Crem2y/rp2350a_main_board/documentation/pcb.png

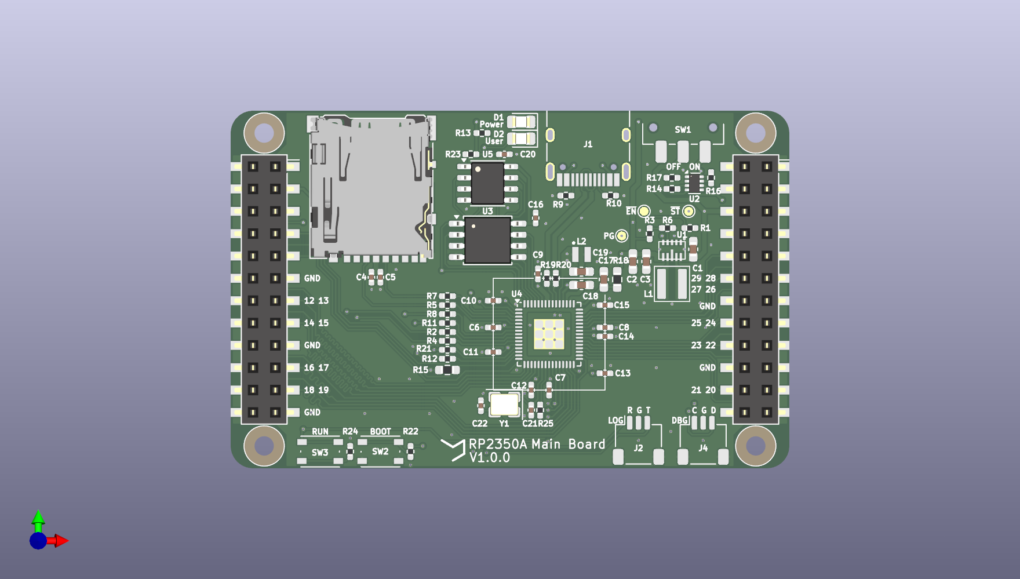
documentation/pcb.png
