Crem2y/rp2350a_main_board/documentation/schematics.pdf

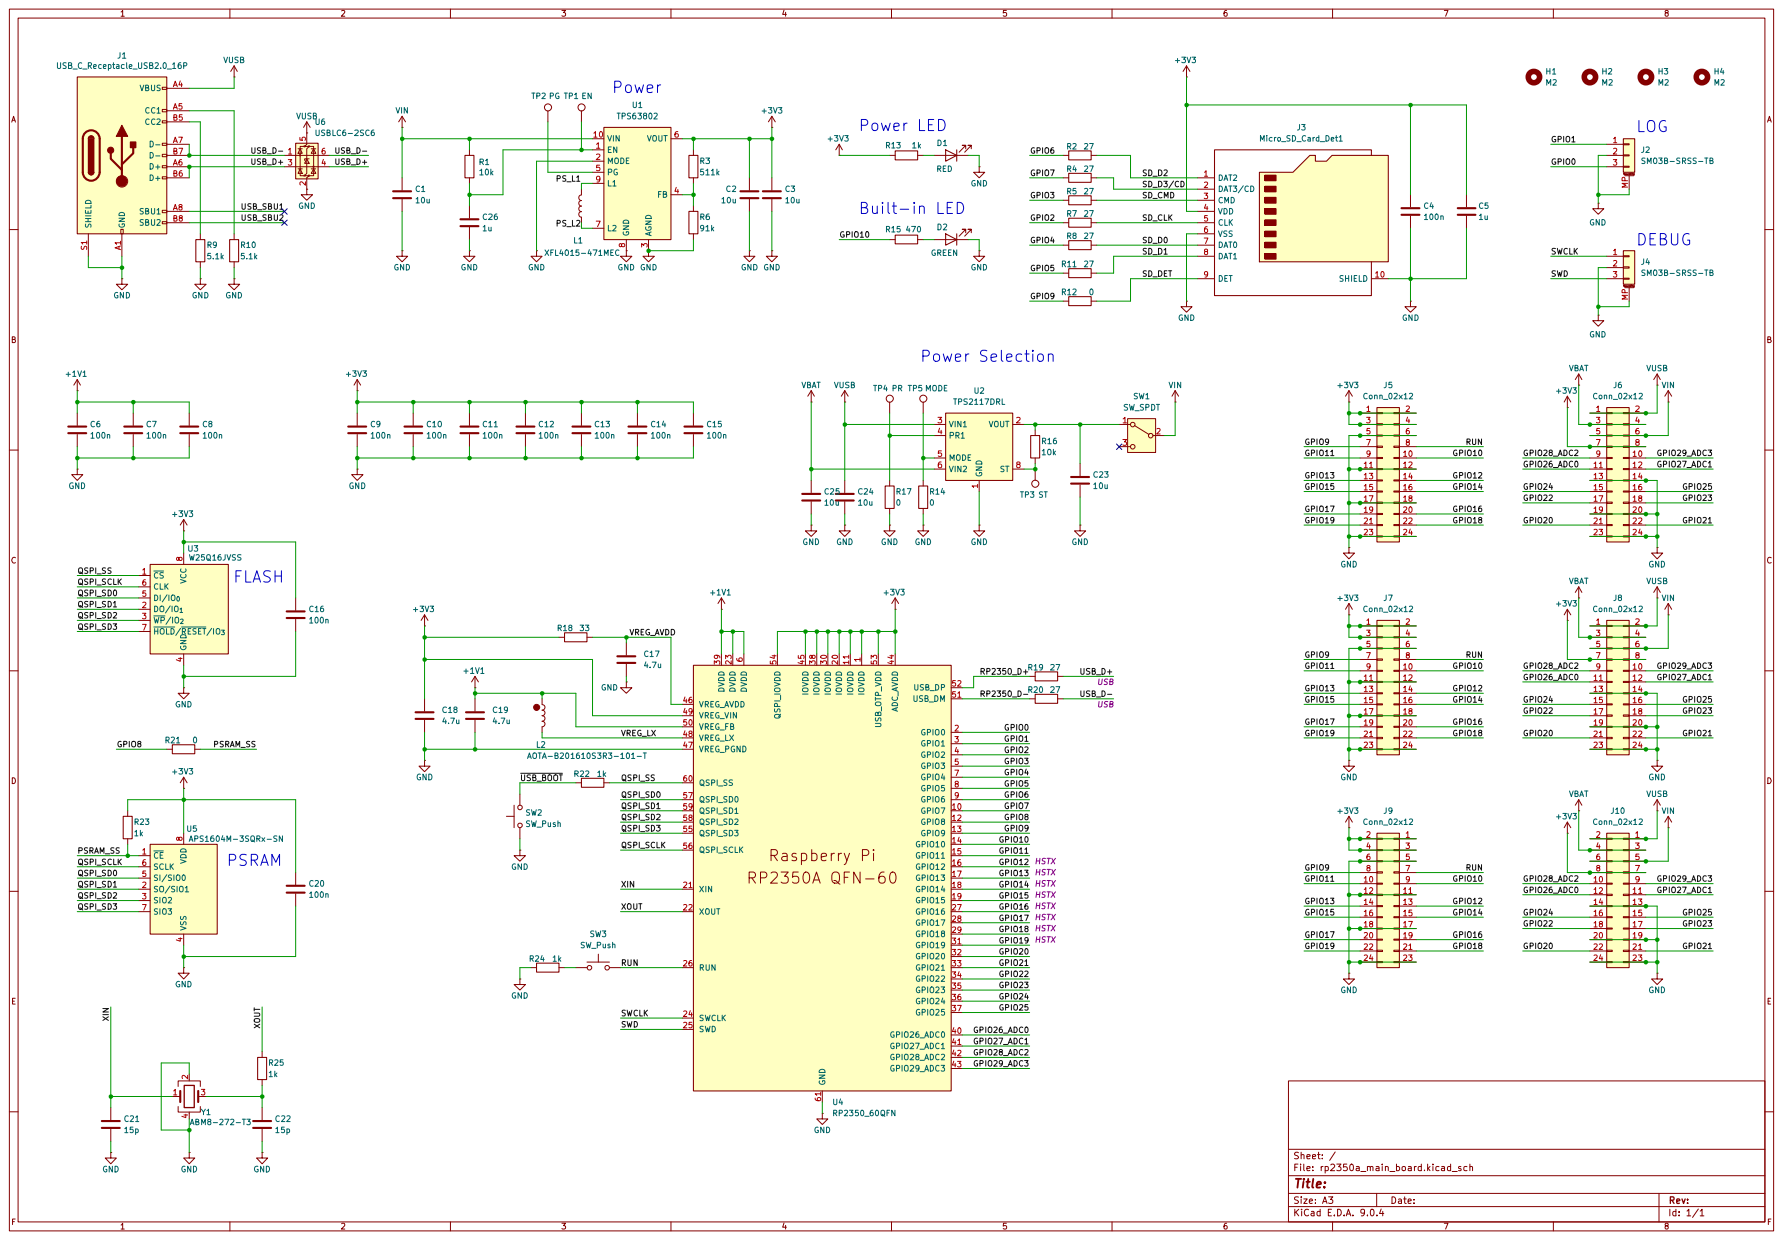
[picture p7: page 1]
