Crem2y/rp2350a_main_board/documentation/old_1.0.0/schematics.pdf

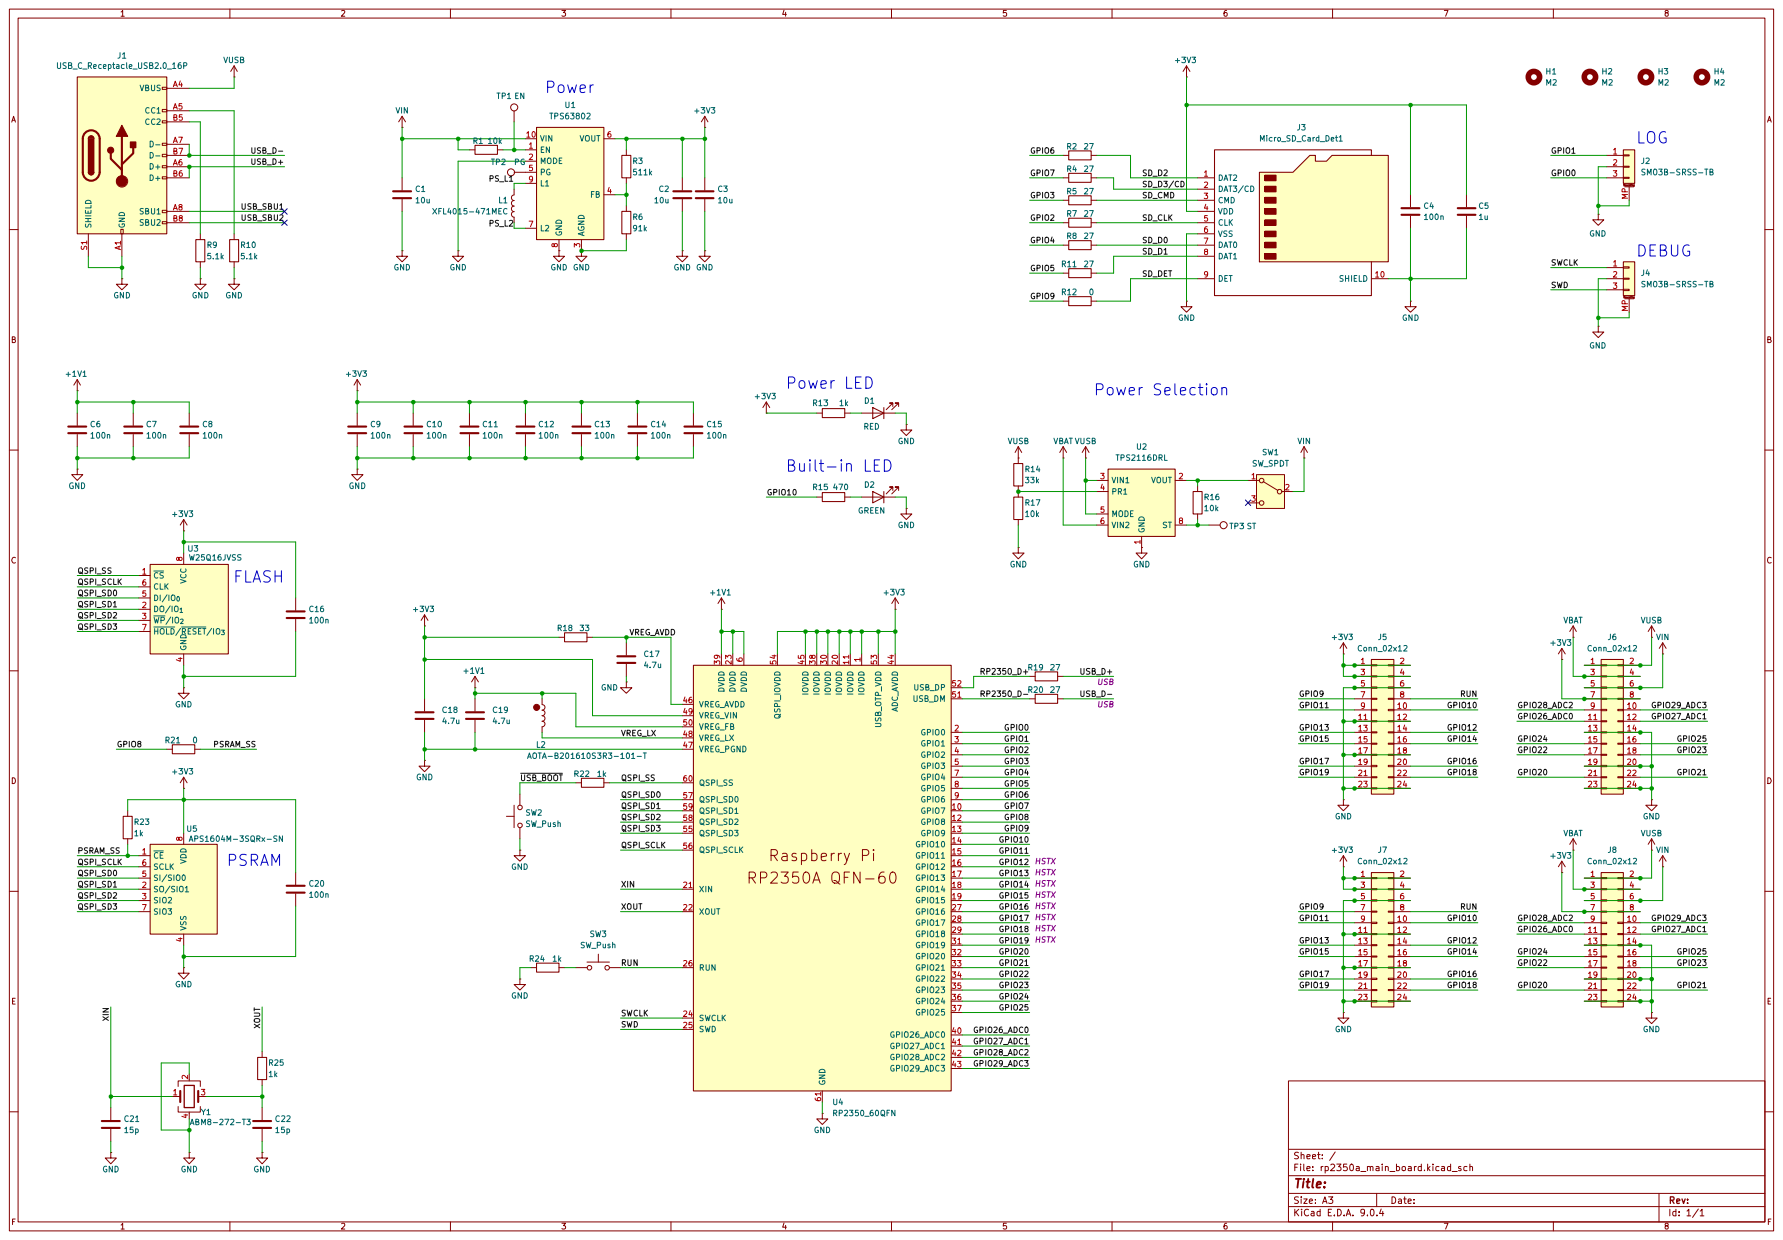
[picture p8: page 1]
