Crem2y/rp2350a_main_board/rp2350a_main_board.kicad_pcb

## KiCad design rp2350a_main_board.kicad_pcb (2026-08-28)

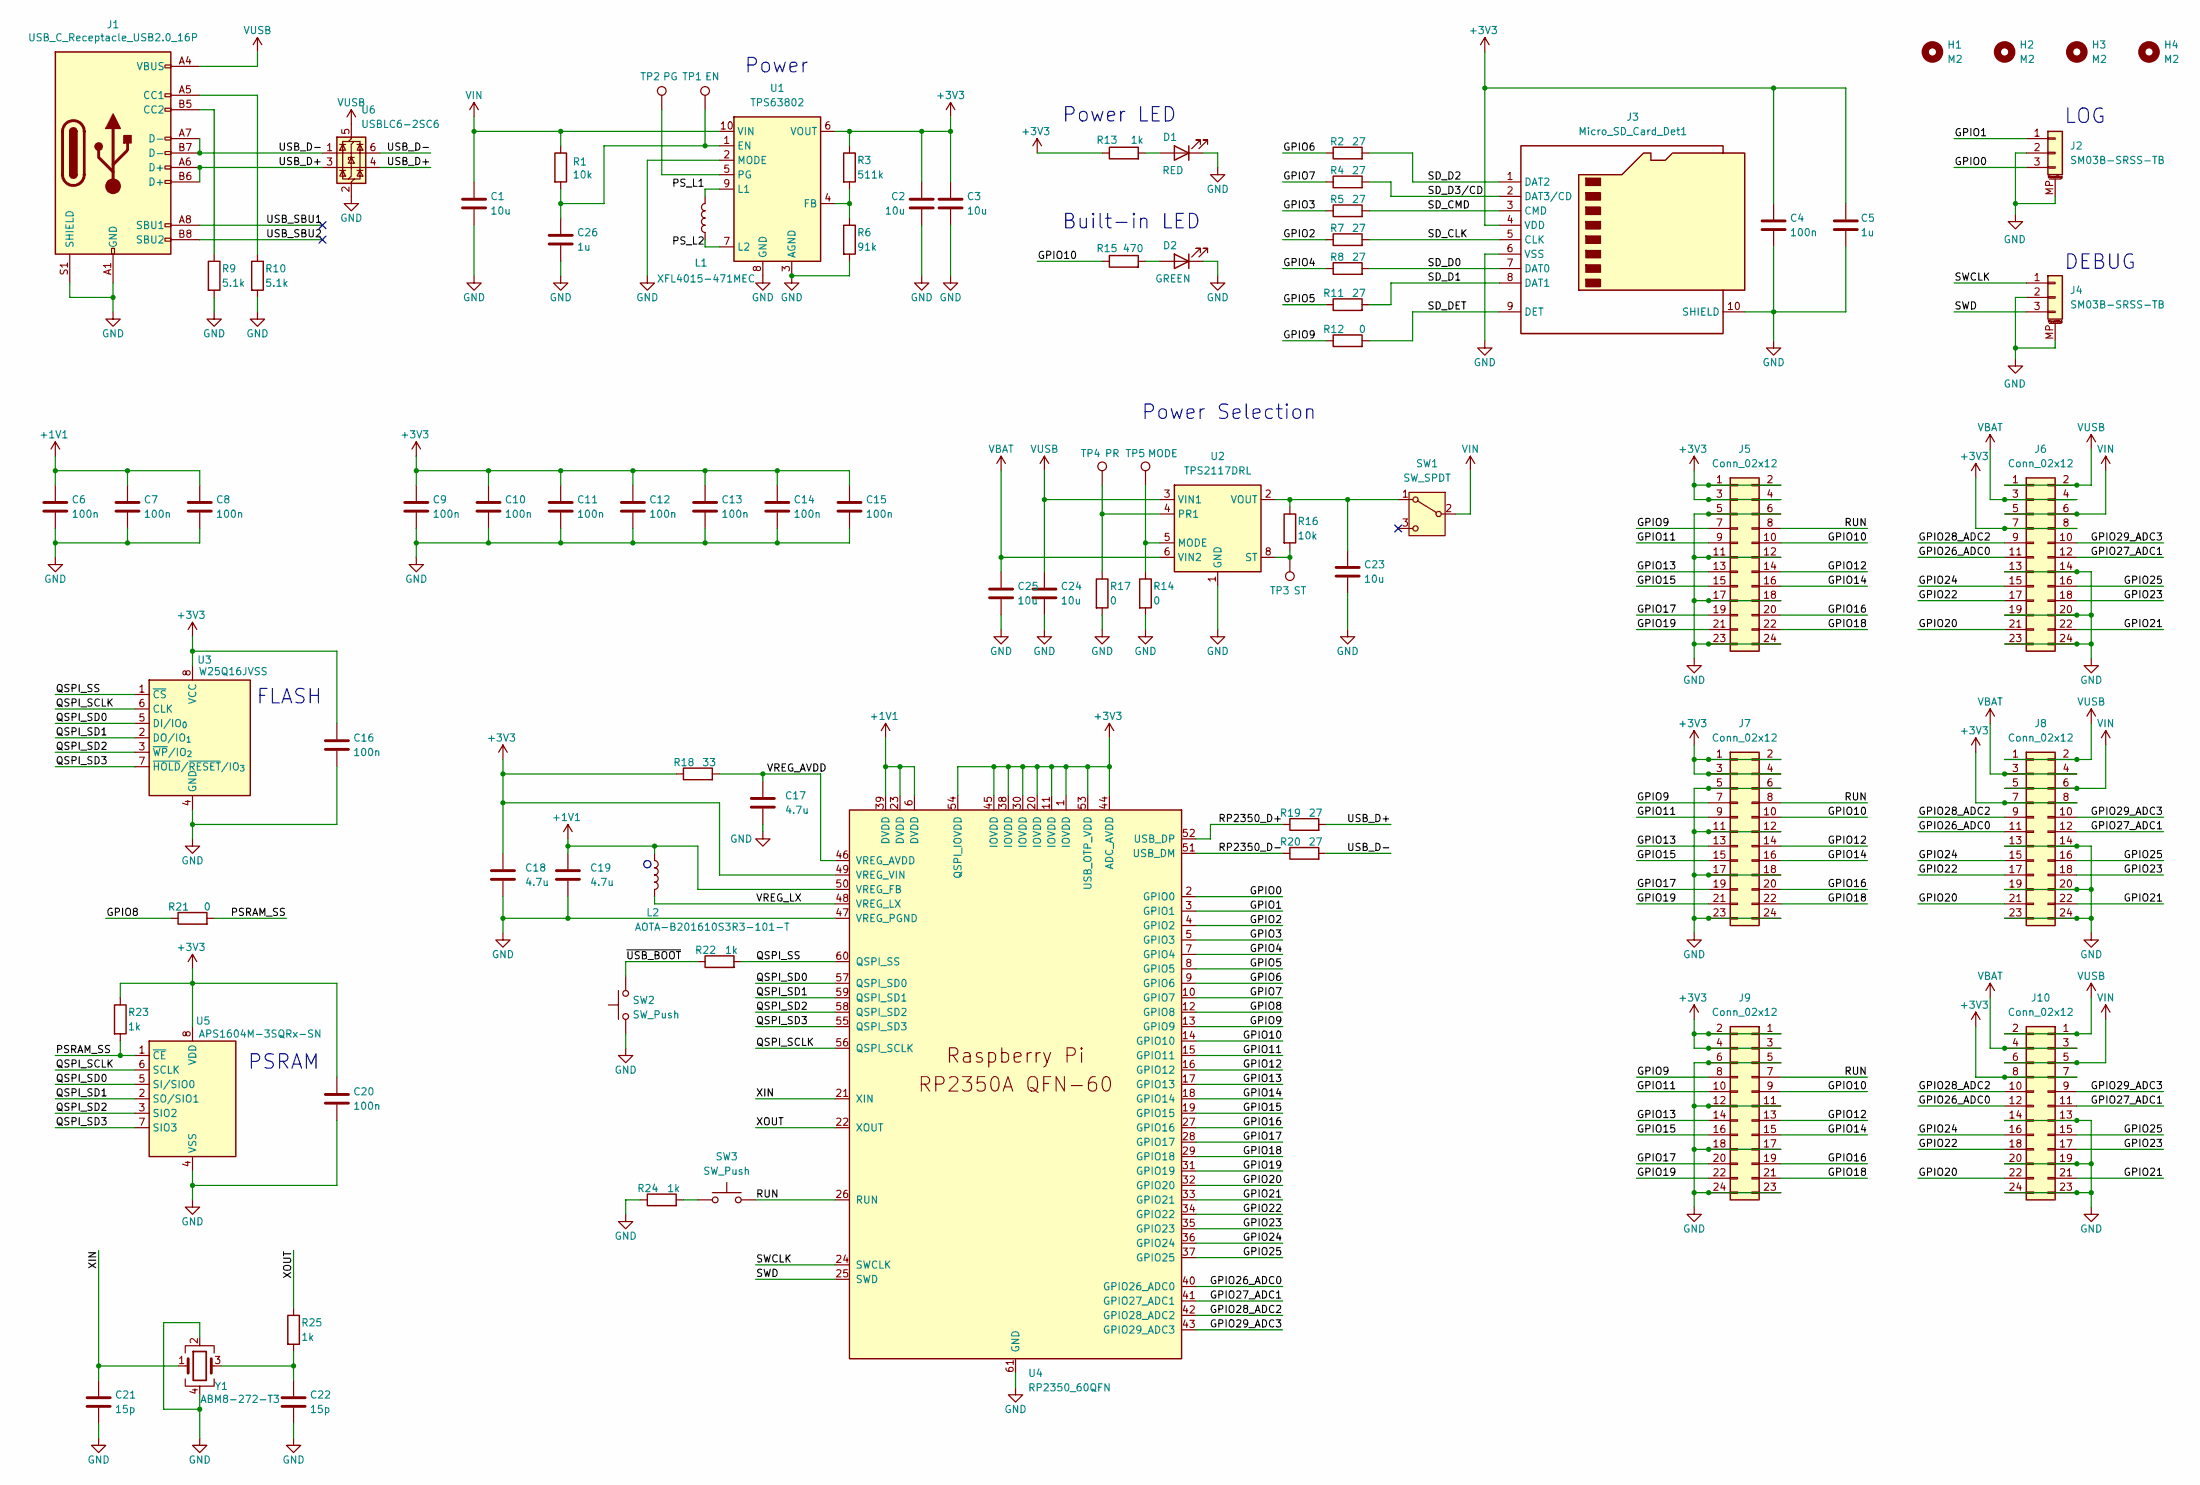
[picture p9: schematic rp2350a_main_board.kicad_sch]

Parts:
C1, C2, C3, C23, C24, C25: 10u; C_0603_1608Metric_Pad1.08x0.95mm_HandSolder
C4, C6, C7, C8, C9, C10, C11, C12, C13, C14, C15, C16, C20: 100n; C_0402_1005Metric_Pad0.74x0.62mm_HandSolder
C5, C26: 1u; C_0402_1005Metric_Pad0.74x0.62mm_HandSolder
C17, C18, C19: 4.7u; C_0603_1608Metric_Pad1.08x0.95mm_HandSolder
C21, C22: 15p; C_0402_1005Metric_Pad0.74x0.62mm_HandSolder
D1: RED; LED_0805_2012Metric_Pad1.15x1.40mm_HandSolder
D2: GREEN; LED_0805_2012Metric_Pad1.15x1.40mm_HandSolder
H1, H2, H3, H4: M2; MountingHole_2.2mm_M2
J1: USB_C_Receptacle_USB2.0_16P; USB_C_Receptacle_HRO_TYPE-C-31-M-12
J2, J4: SM03B-SRSS-TB; JST_SH_SM03B-SRSS-TB_1x03-1MP_P1.00mm_Horizontal
J3: Micro_SD_Card_Det1; microSD_HC_Hirose_DM3AT-SF-PEJM5
J5, J6: Conn_02x12; PinSocket_2x12_P2.54mm_Vertical
J7, J8, J9, J10: Conn_02x12; PinSocket_2x12_P2.54mm_Vertical_SMD
L1: XFL4015-471MEC; Inductor_SMD_L_4.0x4.0_H1.5
L2: AOTA-B201610S3R3-101-T; L_pol_2016
R1, R16: 10k; R_0402_1005Metric_Pad0.72x0.64mm_HandSolder
R2, R4, R5, R7, R8, R11, R19, R20: 27; R_0402_1005Metric_Pad0.72x0.64mm_HandSolder
R3: 511k; R_0402_1005Metric_Pad0.72x0.64mm_HandSolder
R6: 91k; R_0402_1005Metric_Pad0.72x0.64mm_HandSolder
R9, R10: 5.1k; R_0402_1005Metric_Pad0.72x0.64mm_HandSolder
R12, R14, R17, R21: 0; R_0402_1005Metric_Pad0.72x0.64mm_HandSolder
R13, R22, R23, R24, R25: 1k; R_0402_1005Metric_Pad0.72x0.64mm_HandSolder
R15: 470; R_0402_1005Metric_Pad0.72x0.64mm_HandSolder
R18: 33; R_0603_1608Metric_Pad0.98x0.95mm_HandSolder
SW1: SW_SPDT; SW_SPDT_CK_JS102011SAQN
SW2, SW3: SW_Push; SW_Push_1P1T_NO_Vertical_Wuerth_434133025816
TP1: EN; TestPoint_Pad_D1.0mm
TP2: PG; TestPoint_Pad_D1.0mm
TP3: ST; TestPoint_Pad_D1.0mm
TP4: PR; TestPoint_Pad_D1.0mm
TP5: MODE; TestPoint_Pad_D1.0mm
U1: TPS63802
U2: TPS2117DRL; SOT-583-8
U3: W25Q16JVSS; SOIC-8_5.3x5.3mm_P1.27mm
U4: RP2350_60QFN; QFN-60-1EP_7x7mm_P0.4mm_EP3.4x3.4mm; LCSC PN C42411118
U5: APS1604M-3SQRx-SN; SOIC-8_3.9x4.9mm_P1.27mm
U6: USBLC6-2SC6; SOT-23-6
Y1: ABM8-272-T3; Crystal_SMD_3225-4Pin_3.2x2.5mm; LCSC PN C20625731

Connections:
+1V1: C6.1, C7.1, C8.1, C19.1, L2.1, U4.6 (DVDD), U4.23 (DVDD), U4.39 (DVDD), U4.50 (VREG_FB)
+3V3: C2.1, C3.1, C4.1, C5.1, C9.1, C10.1, C11.1, C12.1, C13.1, C14.1, C15.1, C16.1, C18.1, C20.1, J3.4 (VDD), J5.1, J5.2, J5.3, J5.4, J6.7, J6.8, J7.1, J7.2, J7.3, J7.4, J8.7, J8.8, J9.1, J9.2, J9.3, J9.4, J10.7, J10.8, R3.1, R13.1, R18.1, R23.1, U1.6 (VOUT), U3.8 (VCC), U4.1 (IOVDD), U4.11 (IOVDD), U4.20 (IOVDD), U4.30 (IOVDD), U4.38 (IOVDD), U4.44 (ADC_AVDD), U4.45 (IOVDD), U4.49 (VREG_VIN), U4.53 (USB_OTP_VDD), U4.54 (QSPI_IOVDD), U5.8 (VDD)
/GPIO0: J2.3, U4.2 (GPIO0)
/GPIO1: J2.1, U4.3 (GPIO1)
/GPIO2: R7.1, U4.4 (GPIO2)
/GPIO3: R5.1, U4.5 (GPIO3)
/GPIO4: R8.1, U4.7 (GPIO4)
/GPIO5: R11.1, U4.8 (GPIO5)
/GPIO6: R2.1, U4.9 (GPIO6)
/GPIO7: R4.1, U4.10 (GPIO7)
/GPIO8: R21.1, U4.12 (GPIO8)
/GPIO9: J5.7, J7.7, J9.8, R12.1, U4.13 (GPIO9)
/GPIO10: J5.10, J7.10, J9.9, R15.1, U4.14 (GPIO10)
/GPIO11: J5.9, J7.9, J9.10, U4.15 (GPIO11)
/GPIO12: J5.14, J7.14, J9.13, U4.16 (GPIO12)
/GPIO13: J5.13, J7.13, J9.14, U4.17 (GPIO13)
/GPIO14: J5.16, J7.16, J9.15, U4.18 (GPIO14)
/GPIO15: J5.15, J7.15, J9.16, U4.19 (GPIO15)
/GPIO16: J5.20, J7.20, J9.19, U4.27 (GPIO16)
/GPIO17: J5.19, J7.19, J9.20, U4.28 (GPIO17)
/GPIO18: J5.22, J7.22, J9.21, U4.29 (GPIO18)
/GPIO19: J5.21, J7.21, J9.22, U4.31 (GPIO19)
/GPIO20: J6.21, J8.21, J10.22, U4.32 (GPIO20)
/GPIO21: J6.22, J8.22, J10.21, U4.33 (GPIO21)
/GPIO22: J6.17, J8.17, J10.18, U4.34 (GPIO22)
/GPIO23: J6.18, J8.18, J10.17, U4.35 (GPIO23)
/GPIO24: J6.15, J8.15, J10.16, U4.36 (GPIO24)
/GPIO25: J6.16, J8.16, J10.15, U4.37 (GPIO25)
/GPIO26_ADC0: J6.11, J8.11, J10.12, U4.40 (GPIO26_ADC0)
/GPIO27_ADC1: J6.12, J8.12, J10.11, U4.41 (GPIO27_ADC1)
/GPIO28_ADC2: J6.9, J8.9, J10.10, U4.42 (GPIO28_ADC2)
/GPIO29_ADC3: J6.10, J8.10, J10.9, U4.43 (GPIO29_ADC3)
/PSRAM_SS: R21.2, R23.2, U5.1 (~CE)
/PS_L1: L1.1, U1.9 (L1)
/PS_L2: L1.2, U1.7 (L2)
/QSPI_SCLK: U3.6 (CLK), U4.56 (QSPI_SCLK), U5.6 (SCLK)
/QSPI_SD0: U3.5 (DI/IO_{0}), U4.57 (QSPI_SD0), U5.5 (SI/SIO0)
/QSPI_SD1: U3.2 (DO/IO_{1}), U4.59 (QSPI_SD1), U5.2 (SO/SIO1)
/QSPI_SD2: U3.3 (~WP/IO_{2}), U4.58 (QSPI_SD2), U5.3 (SIO2)
/QSPI_SD3: U3.7 (~HOLD/~RESET/IO_{3}), U4.55 (QSPI_SD3), U5.7 (SIO3)
/QSPI_SS: R22.2, U3.1 (~CS), U4.60 (QSPI_SS)
/RP2350_D+: R19.1, U4.52 (USB_DP)
/RP2350_D-: R20.1, U4.51 (USB_DM)
/RUN: J5.8, J7.8, J9.7, SW3.2, U4.26 (RUN)
/SD_CLK: J3.5 (CLK), R7.2
/SD_CMD: J3.3 (CMD), R5.2
/SD_D0: J3.7 (DAT0), R8.2
/SD_D1: J3.8 (DAT1), R11.2
/SD_D2: J3.1 (DAT2), R2.2
/SD_D3/CD: J3.2 (DAT3/CD), R4.2
/SD_DET: J3.9 (DET), R12.2
/SWCLK: J4.1, U4.24 (SWCLK)
/SWD: J4.3, U4.25 (SWD)
/USB_D+: J1.A6 (D+), J1.B6 (D+), R19.2, U6.3 (I/O2), U6.4 (I/O2)
/USB_D-: J1.A7 (D-), J1.B7 (D-), R20.2, U6.1 (I/O1), U6.6 (I/O1)
/USB_SBU1: J1.A8 (SBU1)
/USB_SBU2: J1.B8 (SBU2)
/VREG_AVDD: C17.1, R18.2, U4.46 (VREG_AVDD)
/VREG_LX: L2.2, U4.48 (VREG_LX)
/XIN: C21.1, U4.21 (XIN), Y1.1
/XOUT: R25.1, U4.22 (XOUT)
/~USB_BOOT: R22.1, SW2.2
GND: C1.2, C2.2, C3.2, C4.2, C5.2, C6.2, C7.2, C8.2, C9.2, C10.2, C11.2, C12.2, C13.2, C14.2, C15.2, C16.2, C17.2, C18.2, C19.2, C20.2, C21.2, C22.2, C23.2, C24.2, C25.2, C26.2, D1.1 (K), D2.1 (K), J1.A1 (GND), J1.A12 (GND), J1.B1 (GND), J1.B12 (GND), J1.S1 (SHIELD), J2.2, J2.MP (MountPin), J3.6 (VSS), J3.10 (SHIELD), J4.2, J4.MP (MountPin), J5.5, J5.6, J5.11, J5.12, J5.17, J5.18, J5.23, J5.24, J6.13, J6.14, J6.19, J6.20, J6.23, J6.24, J7.5, J7.6, J7.11, J7.12, J7.17, J7.18, J7.23, J7.24, J8.13, J8.14, J8.19, J8.20, J8.23, J8.24, J9.5, J9.6, J9.11, J9.12, J9.17, J9.18, J9.23, J9.24, J10.13, J10.14, J10.19, J10.20, J10.23, J10.24, R6.2, R9.2, R10.2, R14.2, R17.2, R24.1, SW2.1, U1.2 (MODE), U1.3 (AGND), U1.8 (GND), U2.1 (GND), U3.4 (GND), U4.47 (VREG_PGND), U4.61 (GND), U5.4 (VSS), U6.2 (GND), Y1.2, Y1.4
unnamed: C22.1, R25.2, Y1.3
unnamed: D1.2 (A), R13.2
unnamed: D2.2 (A), R15.2
unnamed: J1.A5 (CC1), R10.1
unnamed: J1.B5 (CC2), R9.1
unnamed: R24.2, SW3.1
unnamed: C23.1, R16.1, SW1.1 (A), U2.2 (VOUT), U2.7 (VOUT)
unnamed: C26.1, R1.2, TP1.1, U1.1 (EN)
unnamed: R3.2, R6.1, U1.4 (FB)
unnamed: TP2.1, U1.5 (PG)
unnamed: R14.1, TP5.1, U2.5 (MODE)
unnamed: R17.1, TP4.1, U2.4 (PR1)
unnamed: R16.2, TP3.1, U2.8 (ST)
VBAT: C25.1, J6.3, J6.4, J8.3, J8.4, J10.3, J10.4, U2.6 (VIN2)
VIN: C1.1, J6.5, J6.6, J8.5, J8.6, J10.5, J10.6, R1.1, SW1.2 (B), U1.10 (VIN)
VUSB: C24.1, J1.A4 (VBUS), J1.A9 (VBUS), J1.B4 (VBUS), J1.B9 (VBUS), J6.1, J6.2, J8.1, J8.2, J10.1, J10.2, U2.3 (VIN1), U6.5 (VBUS)

Notes on the sheet:
DEBUG
FLASH
Built-in LED
Power LED
PSRAM
Power
LOG
Power Selection

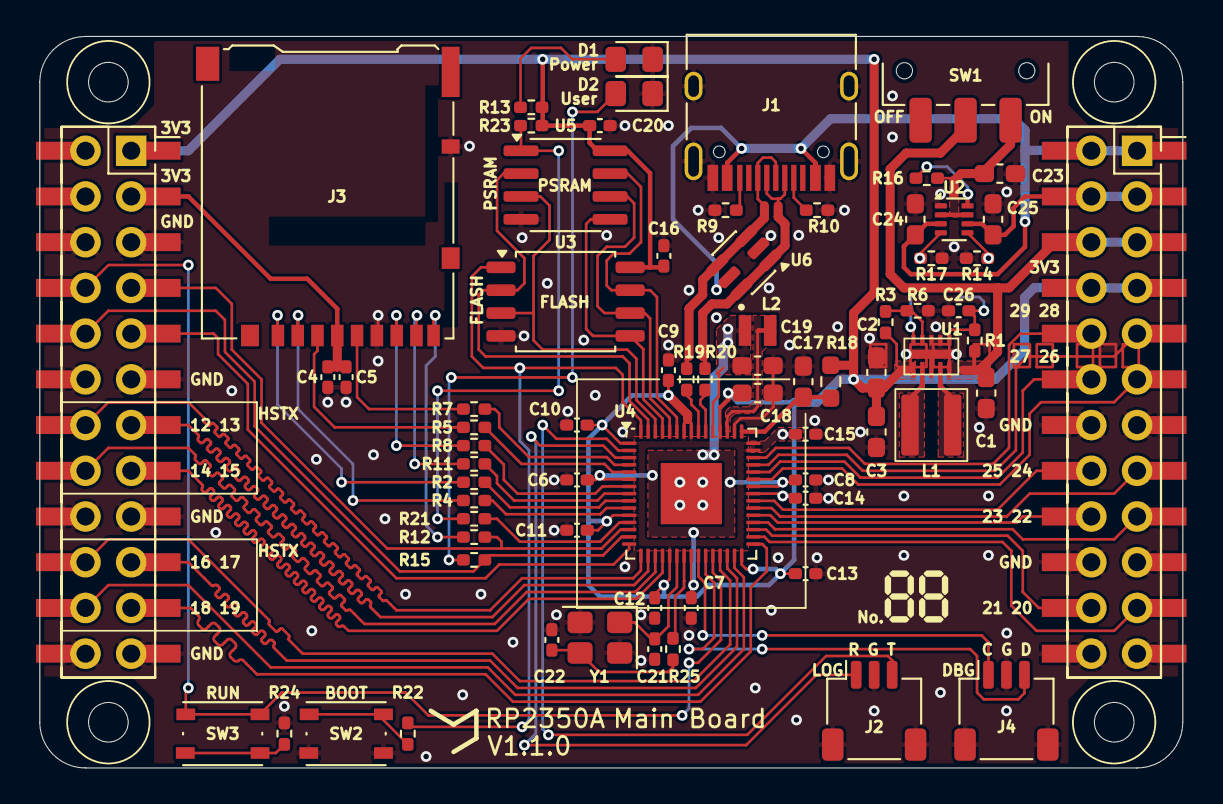
[picture p10: board rp2350a_main_board.kicad_pcb from above]

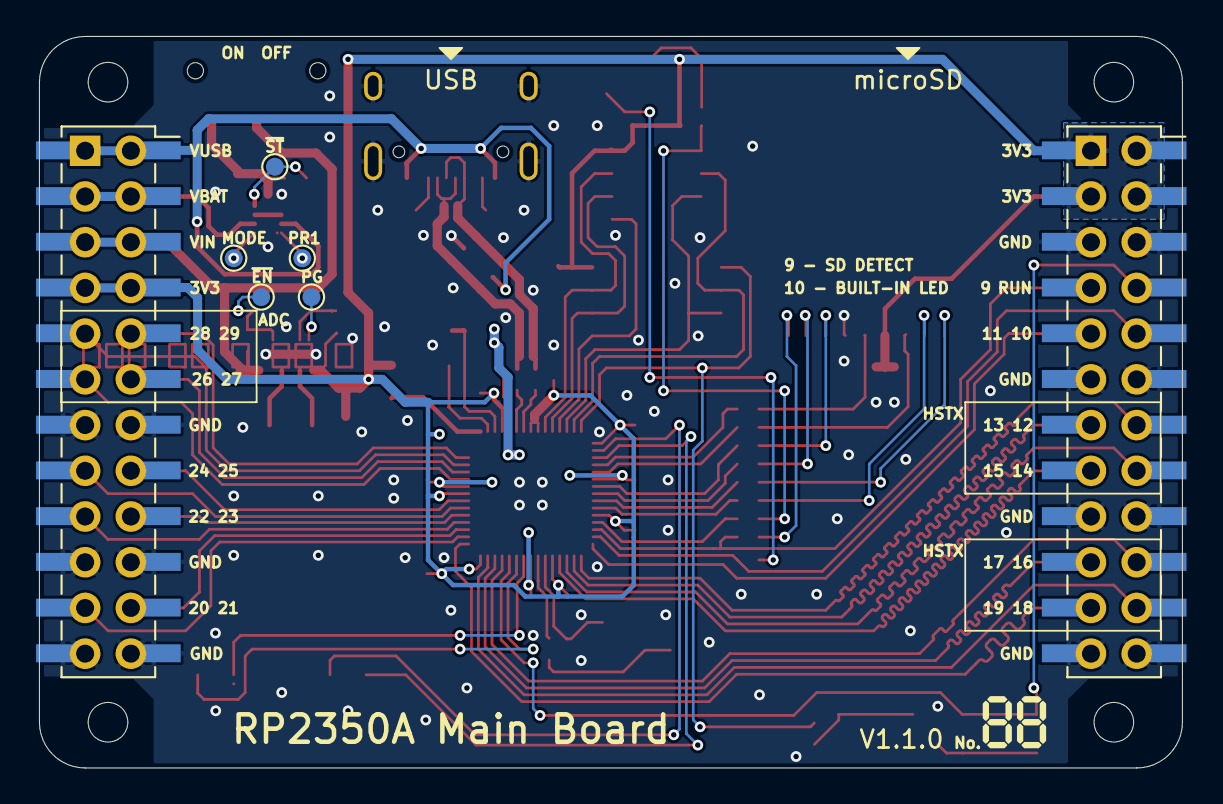
[picture p11: board rp2350a_main_board.kicad_pcb from below]

Board: 2 copper layers, 63.5 x 40.6 mm, 84 parts (7 on the bottom side), 77 nets.
