Crem2y/rp2350a_main_board/(commit log)

2026-05-16 initial commit (copy from https://github.com/Crem2y/rp2350a_test_board)
    [rp2350a_main_board.kicad_pcb, rp2350a_main_board.kicad_sch]
2026-05-16 Add footprints
2026-05-16 Clean up component references
    [rp2350a_main_board.kicad_pcb, rp2350a_main_board.kicad_sch]
2026-05-16 Update BOM list
    [rp2350a_main_board.kicad_pcb, rp2350a_main_board.kicad_sch]
2026-05-16 Add text, Add part name to L1
    [rp2350a_main_board.kicad_pcb, rp2350a_main_board.kicad_sch]
2026-08-25 Switch to TPS2117 and update power circuit
    [rp2350a_main_board.kicad_sch]
2026-08-25 Update PCB components, board version, and numbering
    [rp2350a_main_board.kicad_pcb]
2026-08-27 v1.1.0 WIP
    [rp2350a_main_board.kicad_pcb, rp2350a_main_board.kicad_sch]
2026-08-28 Update BOM
    [rp2350a_main_board.kicad_pcb, rp2350a_main_board.kicad_sch]
